keshikan/CurematicCaliper/hardware/partslist/BOM_EN.xlsx

Part No. | Name | Type | Supplier | retailer | Description | Num
BT1 | Coin battery case | CH25-2032LF | COMFORTABLE ELECTRONIC | Akizuki denshi tsusho | CR2032用 | 1
C1, C2 | Ceramic capacitor | GRT155R61E474KE01D | Murata Manufacturing Co., Ltd. | Digikey | 0.47µF 25V | 2
C3～C7 | Ceramic capacitor | TMK105BJ104KV-F | Taiyo Yuden | Digikey | 0.1µF 25V | 5
C8 | Ceramic capacitor | GRM188F11A475ZE20 | Murata Manufacturing Co., Ltd. | Akizuki denshi tsusho | 4.7µF 10V | 1
D1, D2 | Shottky diode | SD0603S040S0R2 | AVX Corporation | Digikey | 40V 200MA | 2
F1 | Polyswitch | MINISMDC010F-2 | Littelfuse Inc. | Digikey | PTC 60V 100mA | 1
J1 | USB Type-C connector | USB4085-GF-A | GCT | Digikey |  | 1
J2 | JTAG connector | PH11-2x5SAG | Chang Enn Co., Ltd. | Akizuki denshi tsusho | 1.27mm pitch 2x5P | 1
J3 | N/A | N/A | N/A | N/A | 2.54mm pitch 1x4P | 1
J4 | Pin header | PH-1X3SG | Useconn Electronics Ltd. | Akizuki denshi tsusho | 2.54mm pitch 1x3P | 1
J5 | Pin header | PH-1X2SG | Useconn Electronics Ltd. | Akizuki denshi tsusho | 2.54mm pitch 1x2P | 1
R1, R2 | Resistor | RK73H1ETTP5101F | KOA | Digikey | 5.1kΩ 1% 1/10W | 2
R3～R5 | Resistor | RK73H1ETTP4701F | KOA | Digikey | 4.7kΩ 1% 1/10W | 3
SW1, SW2 | Tactile switch | JTP1230D | No | Akizuki denshi tsusho |  | 2
SW3 | Slide switch | OS102011MA1QN1 | C&K | Digikey | 12V 100mA | 1
U1 | Regulator | NJM12888F33 | NJR | Akizuki denshi tsusho | NJM12888F | 1
U2 | ESD Diode | ESDA6V1BC6 | STMicroelectronics | Digikey | ESDA6V1BC6 | 1
U3, U5 | Hall sensor | ‎DRV5055A2QDBZR | Texas Instruments | Digikey | ‎DRV5055A2QDBZR | 2
U4 | Microcontroller | STM32L422KBU6 | STMicroelectronics | Digikey | STM32L422KBU | 1
PCB | PCB | N/A | SeeedStudio | order | 4-layer ENIG t=1.6mm | 1
OLED | OLED module | SSD1306(128x32) | No brand | Amazon | Soldering to J3 | 1
mech1 | Slider | N/A | N/A | DIY | ABS | 1
mech2 | Basement | N/A | N/A | DIY | ABS | 1
磁石 | Sheet magnet | RSI06 | Niroku seisakusho Co., Ltd. | magnetworld | Cut and stick to mech2 | 1
mech3 | spacer for OLED | N/A | N/A | DIY | ABS | 1
mech4 | spacer for OLED | N/A | N/A | DIY | ABS | 1
mech5 | cap | N/A | Graphic-Print.jp | order | Acryl 2mm UV-printed | 1
NUT AND BOLT | M3 spacer 5mm | N/A | No brand | Aliexpress | M3x5 male and female brass | 3
NUT AND BOLT | M3 nut type-2 | N/A | No brand | Aliexpress | M3 brass | 5
NUT AND BOLT | M3 pan head screw | N/A | No brand | Aliexpress | M3x5 brass | 1
NUT AND BOLT | M3 low head screw | order No 42306083 | Monotaro | Monotaro | M3x8 iron | 4
 |  |  |  |  |  | Note: It is better to match the material of bolt and nut.
