keshikan/CurematicCaliper/hardware/partslist/BOM_JP.xlsx

部品番号 | 名称 | 型番 | メーカ | 購入先 | 定格・備考 | 数量
BT1 | 電池ケース | CH25-2032LF | COMFORTABLE ELECTRONIC | 秋月電子 | CR2032用 | 1
C1, C2 | セラミックコンデンサ | GRT155R61E474KE01D | 村田製作所 | Digikey | 0.47µF 25V | 2
C3～C7 | セラミックコンデンサ | TMK105BJ104KV-F | 太陽誘電 | Digikey | 0.1µF 25V | 5
C8 | セラミックコンデンサ | GRM188F11A475ZE20 | 村田製作所 | 秋月電子 | 4.7µF 10V | 1
D1, D2 | ショットキバリアダイオード | SD0603S040S0R2 | AVX Corporation | Digikey | 40V 200MA | 2
F1 | ポリスイッチ | MINISMDC010F-2 | Littelfuse Inc. | Digikey | PTC 60V 100mA | 1
J1 | USB Type-C コネクタ | USB4085-GF-A | GCT | Digikey |  | 1
J2 | JTAGコネクタ | PH11-2x5SAG | Chang Enn Co., Ltd. | 秋月電子 | 1.27mmピッチ 2x5P | 1
J3 | なし | なし | なし | なし | 2.54mmピッチ 1x4P | 1
J4 | ピンヘッダ | PH-1X3SG | Useconn Electronics Ltd. | 秋月電子 | 2.54mmピッチ 1x3P | 1
J5 | ピンヘッダ | PH-1X2SG | Useconn Electronics Ltd. | 秋月電子 | 2.54mmピッチ 1x2P | 1
R1, R2 | 抵抗 | RK73H1ETTP5101F | KOA | Digikey | 5.1kΩ 1% 1/10W | 2
R3～R5 | 抵抗 | RK73H1ETTP4701F | KOA | Digikey | 4.7kΩ 1% 1/10W | 3
SW1, SW2 | タクトスイッチ | JTP1230D | ノーブランド | 秋月電子 |  | 2
SW3 | スライドスイッチ | OS102011MA1QN1 | C&K | Digikey | 12V 100mA | 1
U1 | レギュレータ | NJM12888F33 | 新日本無線株式会社 | 秋月電子 | NJM12888F | 1
U2 | 保護ダイオード | ESDA6V1BC6 | STMicroelectronics | Digikey | ESDA6V1BC6 | 1
U3, U5 | ホールセンサ | ‎DRV5055A2QDBZR | Texas Instruments | Digikey | ‎DRV5055A2QDBZR | 2
U4 | マイコン | STM32L422KBU6 | STMicroelectronics | Digikey | STM32L422KBU | 1
基板 | プリント基板 | なし | SeeedStudioに外注 | 外注 | 4層 ENIG t=1.6mm | 1
OLED | OLEDモジュール | SSD1306(128x32) | ノーブランド | Amazon | J3に直接ハンダ付け | 1
機構1 | スライダ | なし | なし | 自作 | ABS樹脂製 | 1
機構2 | 本尺 | なし | なし | 自作 | ABS樹脂製 | 1
磁石 | シート磁石 | RSI06 | 二六製作所 | 公式ショップ | カットして機構2に貼付 | 1
機構3 | OLED用スペーサ1 | なし | なし | 自作 | ABS樹脂製 | 1
機構4 | OLED用スペーサ2 | なし | なし | 自作 | ABS樹脂製 | 1
機構5 | フタ | なし | Graphic-Printに外注 | 外注 | アクリル2mm UV印刷 | 1
ボルトナット1 | M3 スペーサ 5mm | なし | ノーブランド | Aliexpress | M3x5 オスメス 黄銅 | 3
ボルトナット2 | M3 2種ナット | なし | ノーブランド | Aliexpress | M3 黄銅 | 5
ボルトナット3 | M3 ナベネジ | なし | ノーブランド | Aliexpress | M3x5 黄銅 | 1
ボルトナット4 | M3 低頭ネジ | 注文番号42306083 | モノタロウ(大阪魂) | モノタロウ | M3x8 鉄 | 4
 |  |  |  |  |  | 注：ボルトナットの素材は合わせた方が良い。今回は余り物を使ったので、黄銅と鉄が混在。
