keshikan/CurematicCaliper/hardware/3dmodel/pcb.step

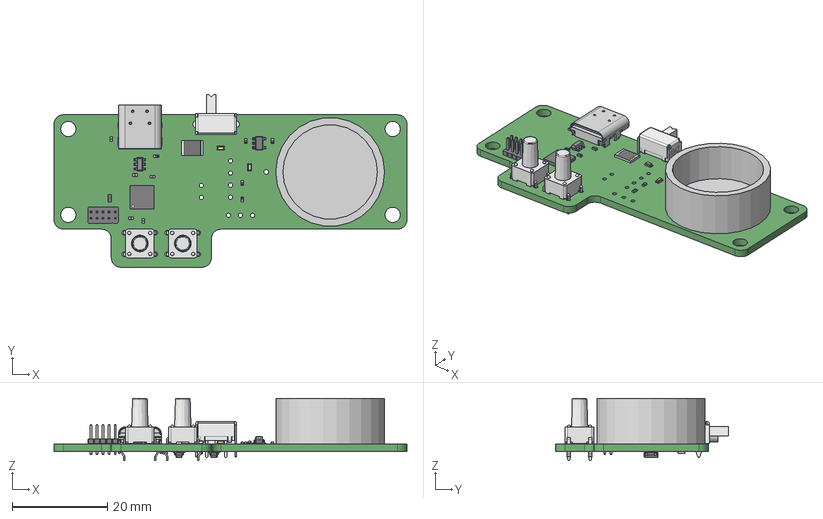
[picture p3: CAD file, 2026-05-07]
hardware/3dmodel/pcb.step
74.0 x 36.2 x 13.1 mm
