keshikan/CurematicCaliper/hardware/schematic/schematic.pdf

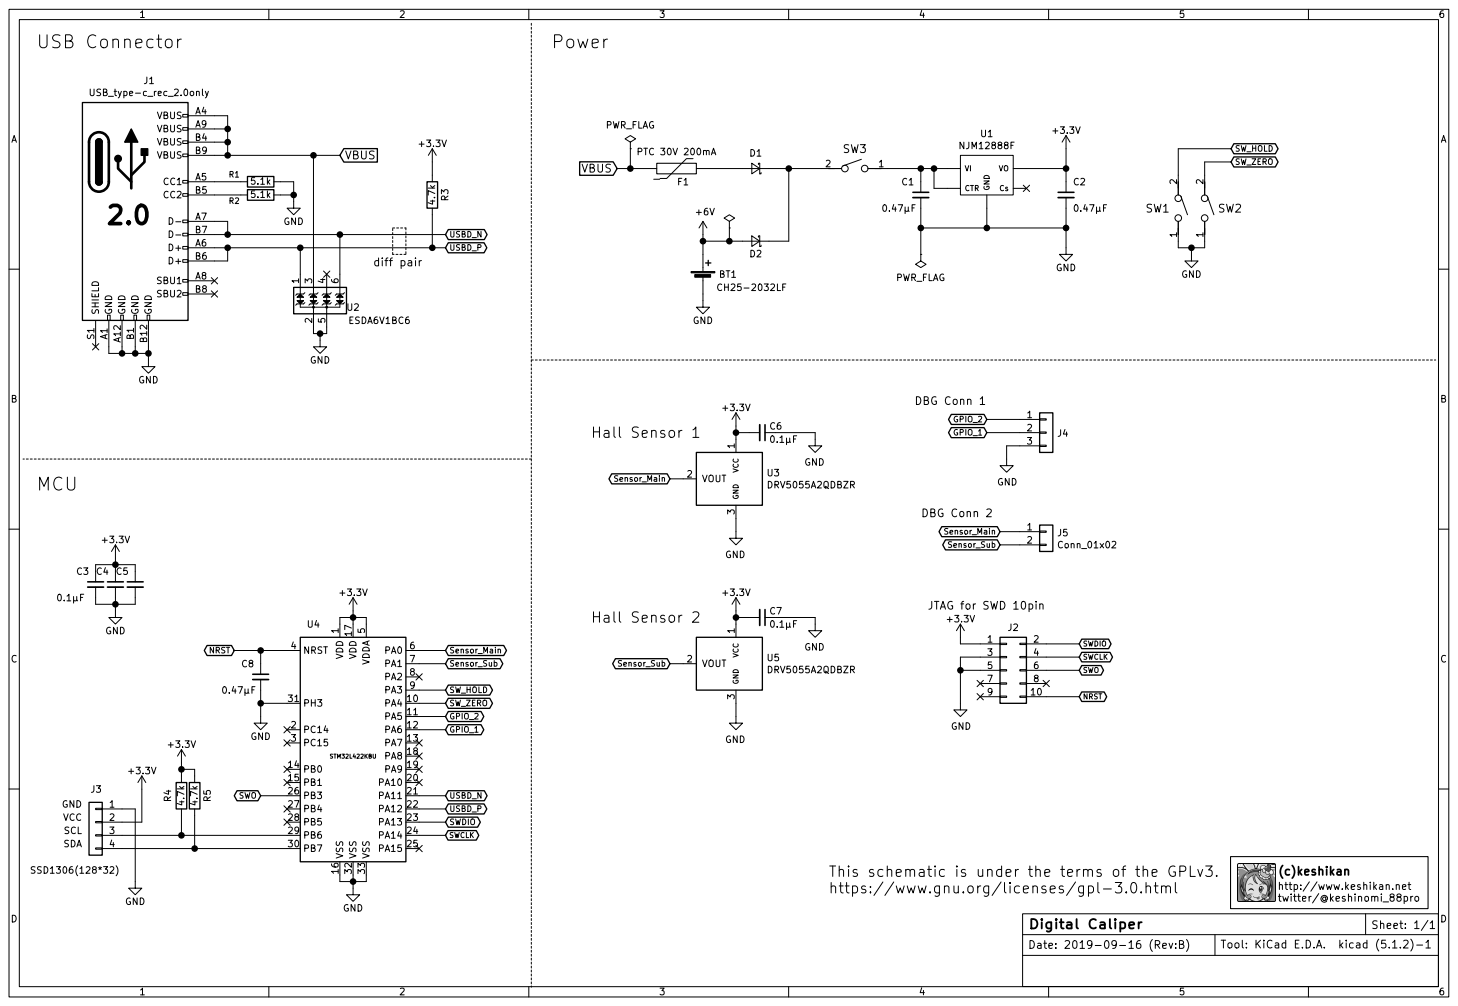
[picture p4: page 1]

https://www.gnu.org/licenses/gpl-3.0.html DBG Conn 1 DBG Conn 2

This schematic is under the terms of the GPLv3.

(c)keshikan
http://www.keshikan.net
