keshikan/CurematicCaliper/(threads)

Thread 1 (2021-08-13):

nice!  some ideas on 3 phases

jschoch, 2021-08-13:
thanks for sharing this.

I tried to do this a few years ago and when I saw your version I tried again, so thanks very much!

My first board used 2 RR111 sensors (very sensitive) and while it worked it had a few issues.  I found this paper:

"https://www.ncbi.nlm.nih.gov/pmc/articles/PMC4634446/"

it describes using 3 sensors 120 degrees apart and then deriving sin/cos for atan2.  This works very nicely.

a quick demonstration you can run on replit.com/languages/c
```
#include <stdio.h>
#include <math.h>

int main() {
	const double sqT = sqrt(3);
	const double sqTH = 0.81649658092772603273242802490196;
        double pole_pitch = 2;
	double a = .5;
	double b = -1;
	double c = .5;
    printf("Hello, world! sqT %lf  %lf\n ",sqT,sqTH);
	double v1 = sqTH * (a - (b/2) - (c/2));
	double v2 = sqTH * ( ((sqT*b)/2)- ((sqT*c)/2)) ;
	printf("v1: %lf v2 %lf \n",v1,v2);
	double ang = atan2(v1,v2);
	double dist = pole_pitch/(M_PI*2) * ang;

	printf("angle: %lf distance %lf",ang);
    return 0;
}
```

i'm still trying to understand your error correction, this seems to do quite a lot on it's own though.
