keshikan/CurematicCaliper/software/cubeide_project/caliper-next.ioc

Mcu.UserName=STM32L422KBUx
PA0-CK_IN.Signal=ADCx_IN5
PA1.Signal=ADCx_IN6
PA11.Signal=USB_DM
PA12.Signal=USB_DP
PA3.Signal=GPIO_Input
PA4.Signal=GPIO_Input
PB6.Signal=I2C1_SCL
PB7.Signal=I2C1_SDA
