keshikan/CurematicCaliper/(commit log)

2019-11-23 added parts list to /hardware/partslist
    [BOM_EN.xlsx, BOM_JP.xlsx]
2026-05-07 Add pcb 3d models, Add Gerber
